MoshirMoshir/DIY-TaTaCon/src/assets/images/Wiring.jpg

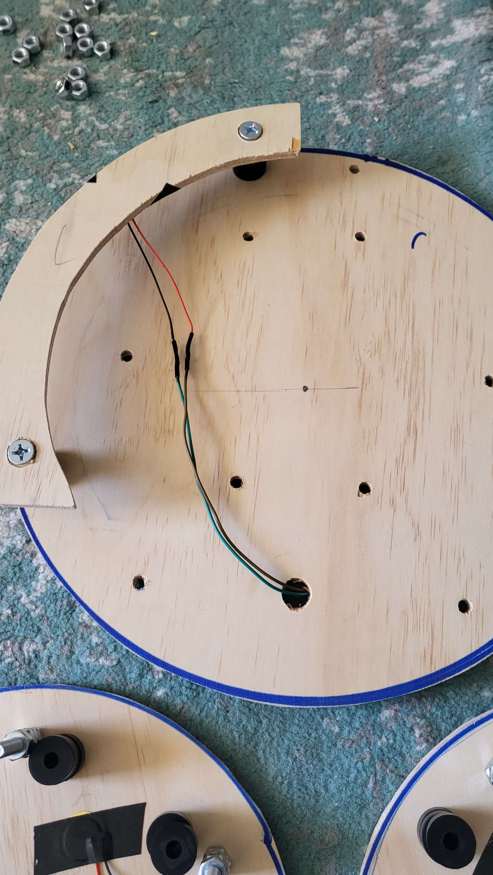
src/assets/images/Wiring.jpg
