MoshirMoshir/DIY-TaTaCon/src/assets/images/Big_Assemble.jpg

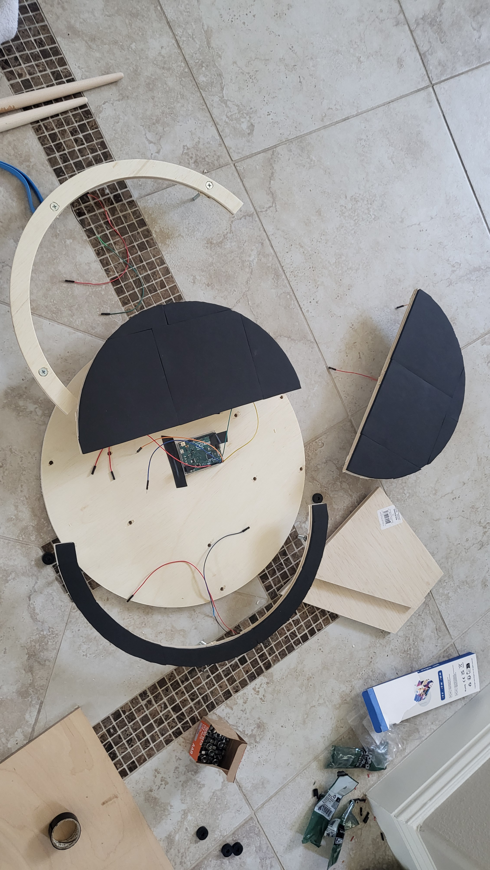
src/assets/images/Big_Assemble.jpg
