MoshirMoshir/DIY-TaTaCon/public/og-image.jpg

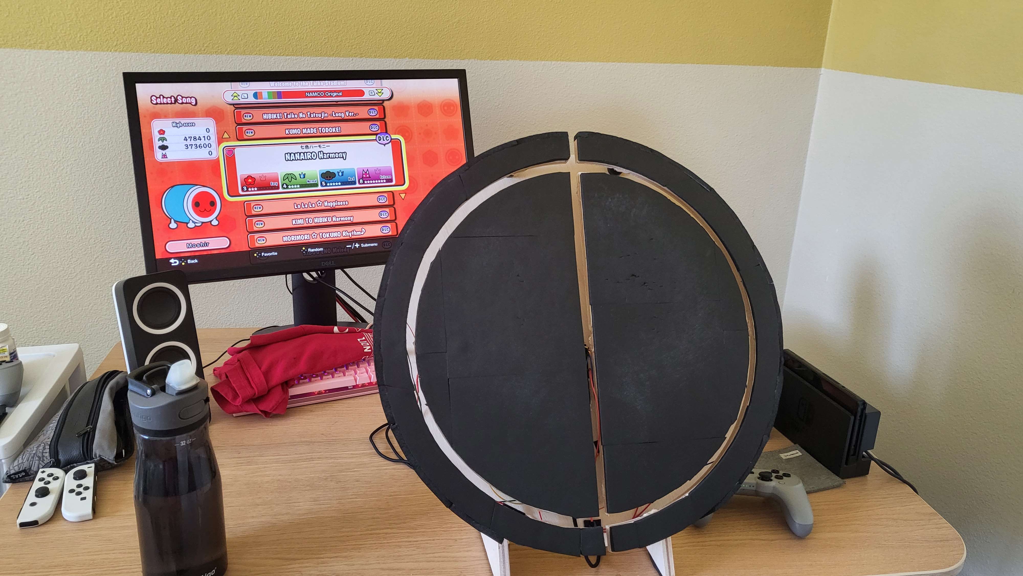
public/og-image.jpg
