MoshirMoshir/DIY-TaTaCon/src/assets/images/Arduino_Back.jpg

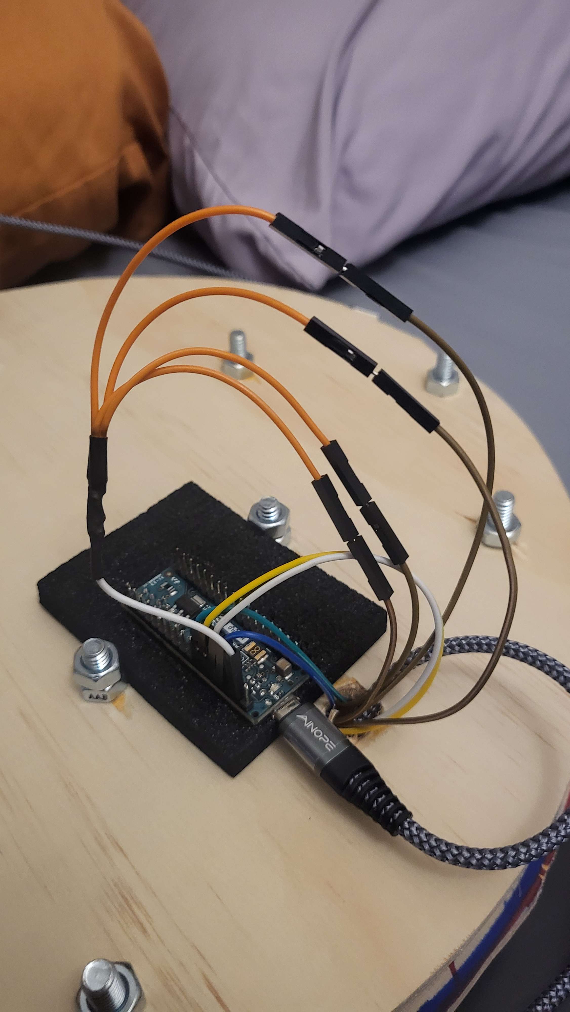
src/assets/images/Arduino_Back.jpg
