MoshirMoshir/DIY-TaTaCon/src/assets/images/Assembeld.jpg

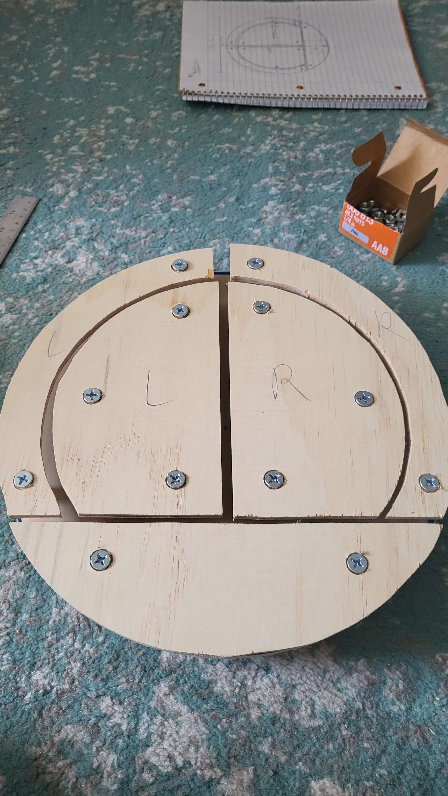
src/assets/images/Assembeld.jpg
