MoshirMoshir/DIY-TaTaCon/src/assets/images/Big_No_Rubber.jpg

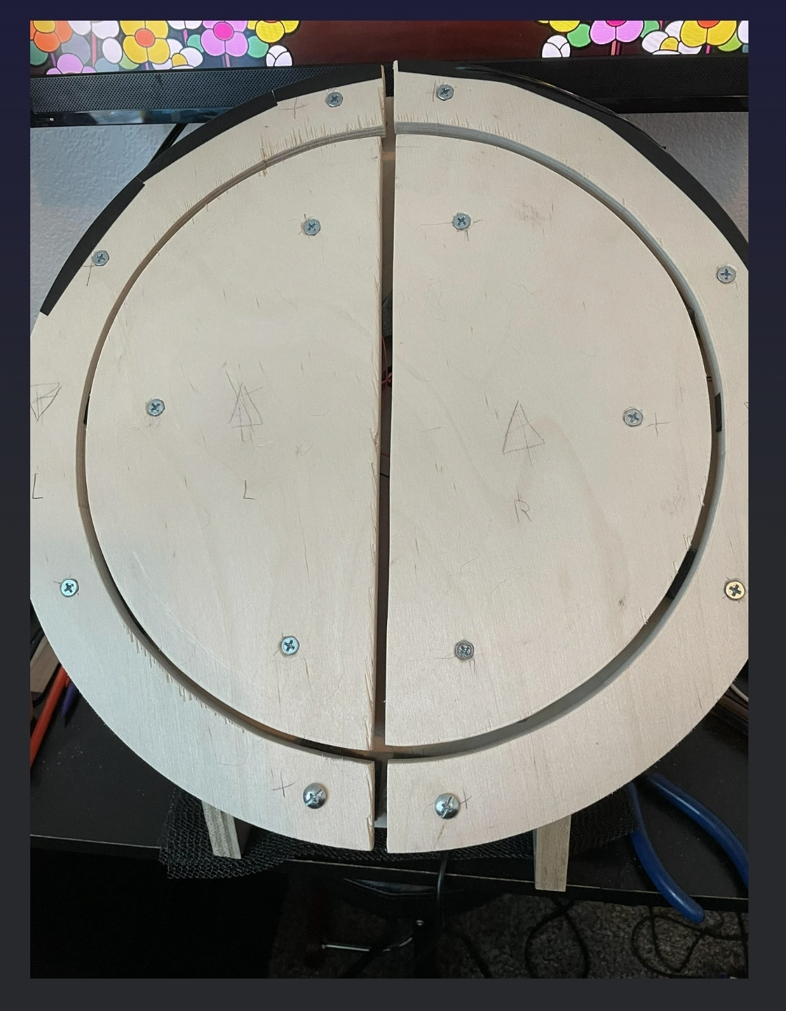
src/assets/images/Big_No_Rubber.jpg
