MoshirMoshir/DIY-TaTaCon/src/assets/images/Big_Wood_Cut.jpg

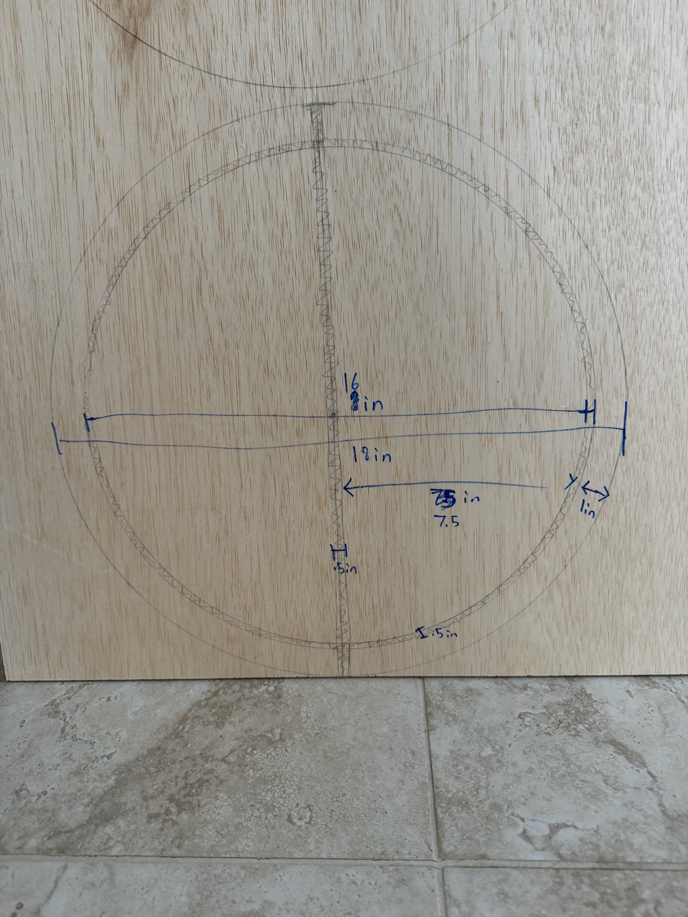
src/assets/images/Big_Wood_Cut.jpg
