MoshirMoshir/DIY-TaTaCon/src/assets/images/Cutting_Rubber.jpg

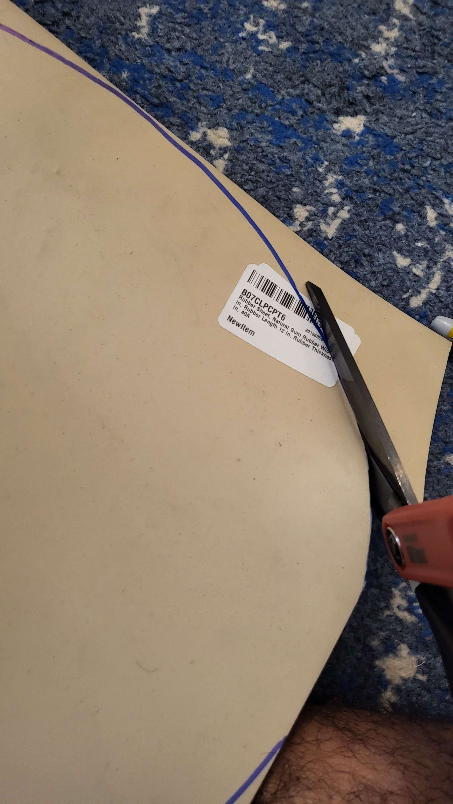
src/assets/images/Cutting_Rubber.jpg
