MoshirMoshir/DIY-TaTaCon/src/assets/images/Extended.jpg

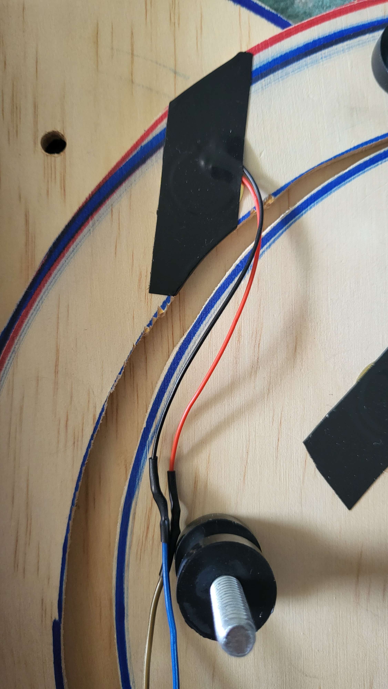
src/assets/images/Extended.jpg
