MoshirMoshir/DIY-TaTaCon/src/assets/images/Glueing.jpg

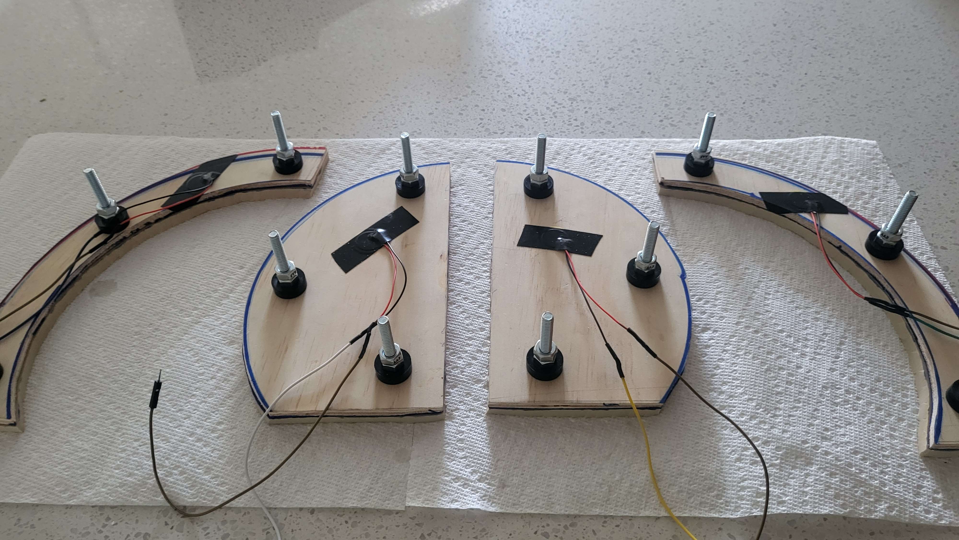
src/assets/images/Glueing.jpg
