MoshirMoshir/DIY-TaTaCon/src/assets/images/Nuts.jpg

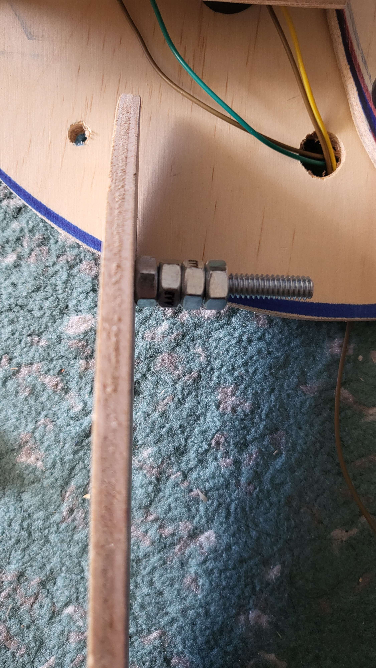
src/assets/images/Nuts.jpg
