MoshirMoshir/DIY-TaTaCon/src/assets/images/Piezo_Sensors.jpg

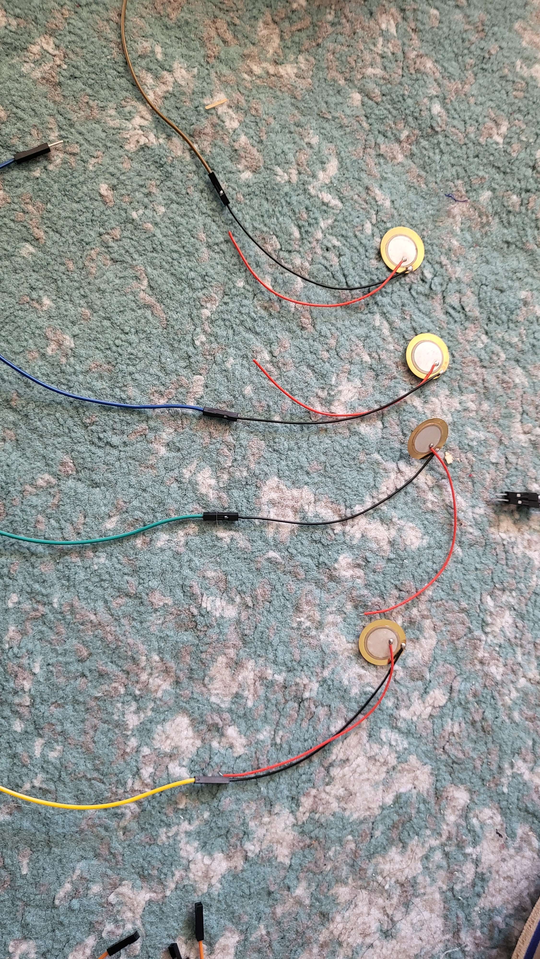
src/assets/images/Piezo_Sensors.jpg
