MoshirMoshir/DIY-TaTaCon/src/assets/images/Small_TaTaCon.jpg

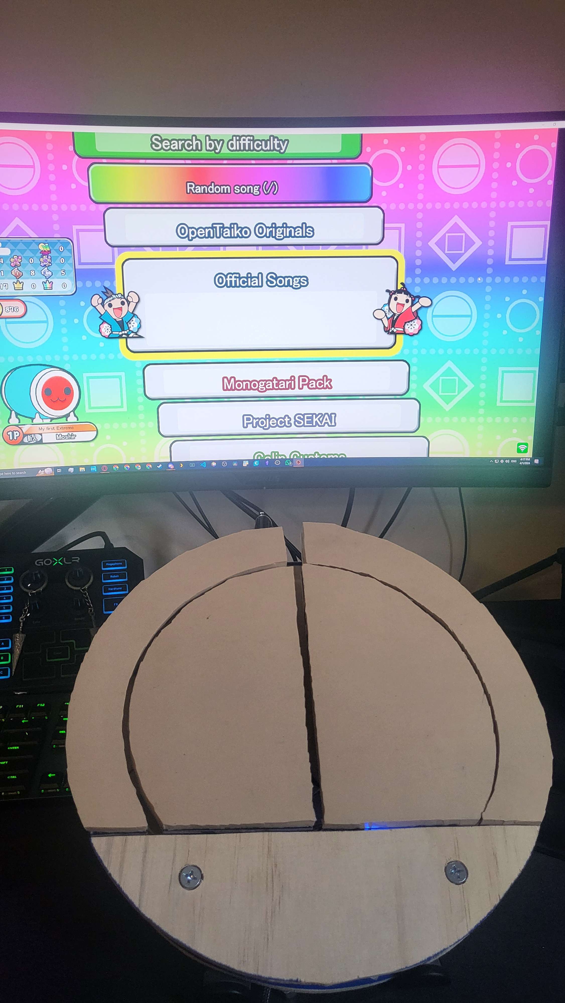
src/assets/images/Small_TaTaCon.jpg
