MoshirMoshir/DIY-TaTaCon/src/assets/images/Small_Uncut.jpg

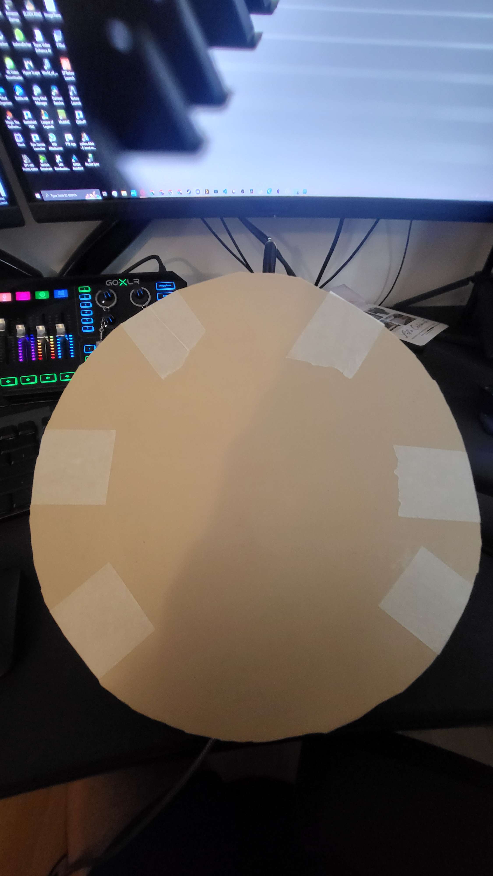
src/assets/images/Small_Uncut.jpg
