MoshirMoshir/DIY-TaTaCon/src/assets/images/Split.jpg

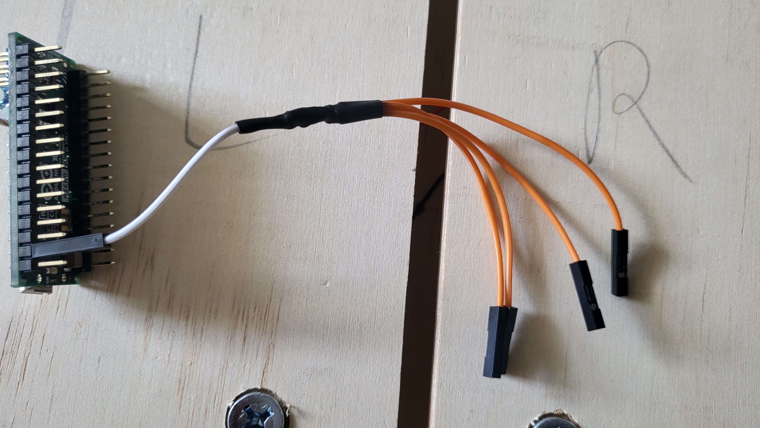
src/assets/images/Split.jpg
