MoshirMoshir/DIY-TaTaCon/src/assets/images/stand.jpg

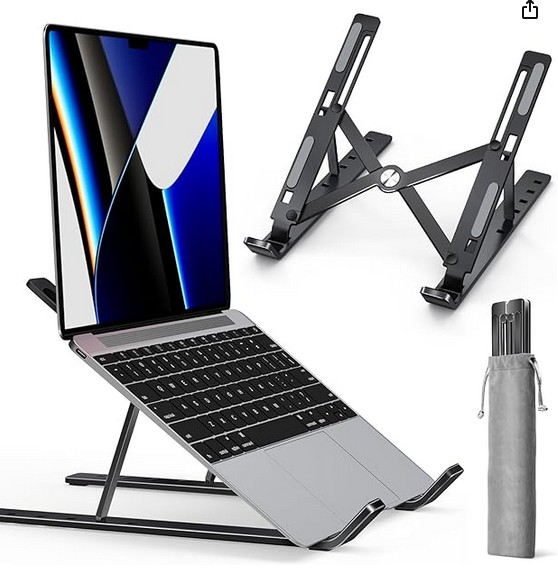
src/assets/images/stand.jpg
