MoshirMoshir/DIY-TaTaCon/src/assets/images/Stripping.jpg

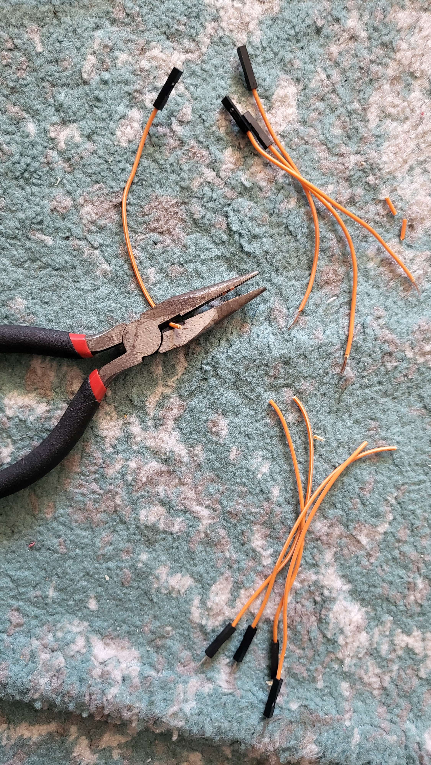
src/assets/images/Stripping.jpg
