MoshirMoshir/DIY-TaTaCon/src/assets/images/Washers.jpg

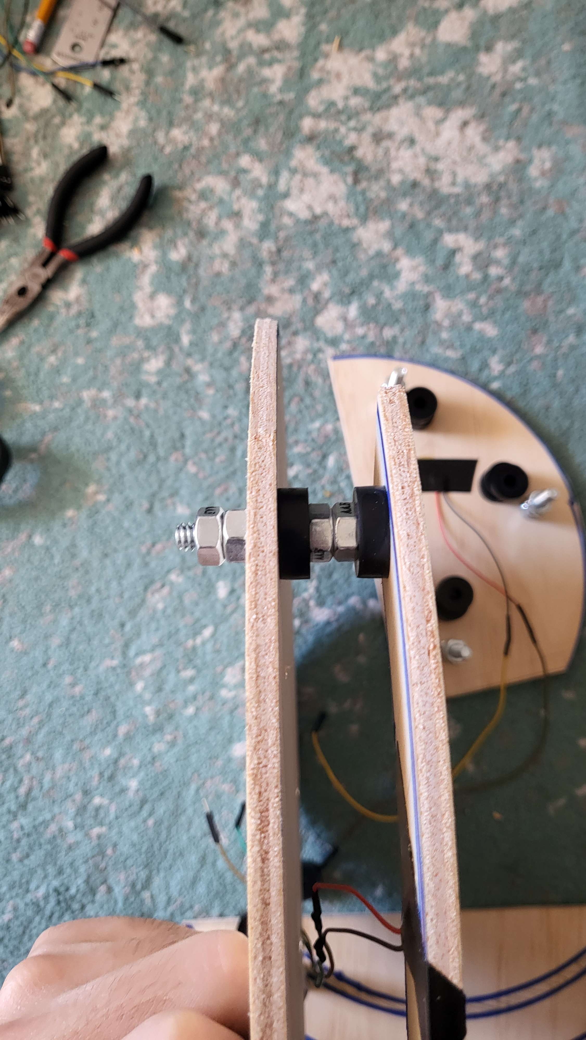
src/assets/images/Washers.jpg
