MoshirMoshir/DIY-TaTaCon/src/assets/images/Wires.jpg

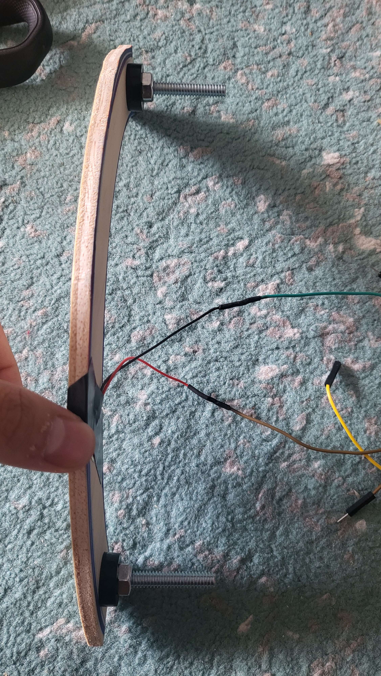
src/assets/images/Wires.jpg
