MoshirMoshir/DIY-TaTaCon/src/assets/images/Wood.jpg

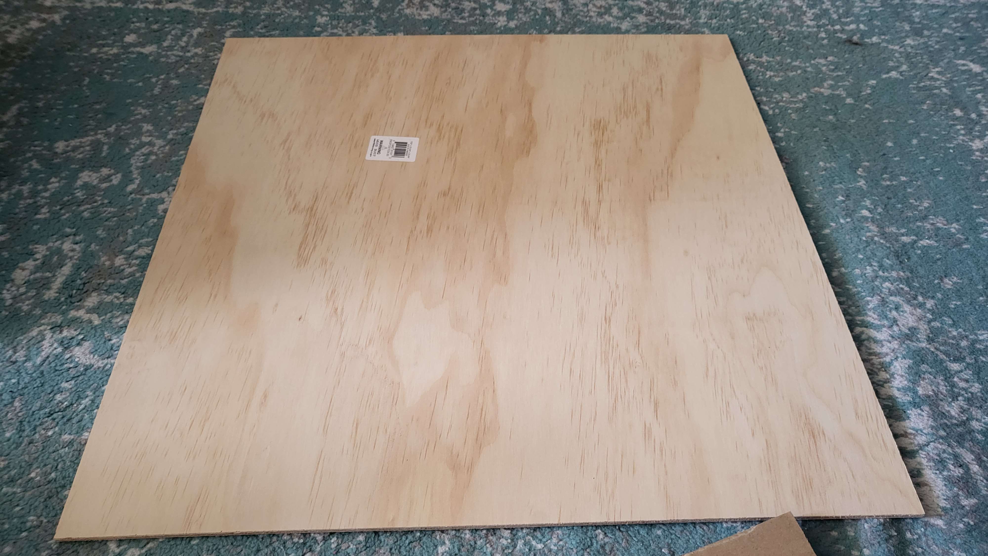
src/assets/images/Wood.jpg
