MoshirMoshir/DIY-TaTaCon/src/assets/images/Wood_Cut.jpg

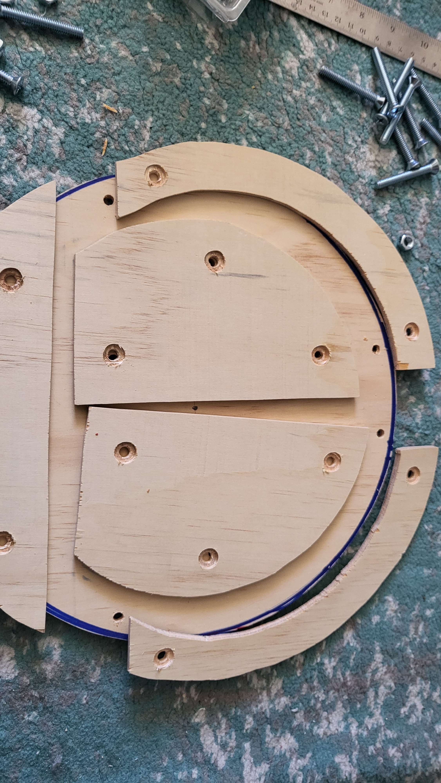
src/assets/images/Wood_Cut.jpg
