MoshirMoshir/DIY-TaTaCon/src/assets/images/Materials_1.jpg

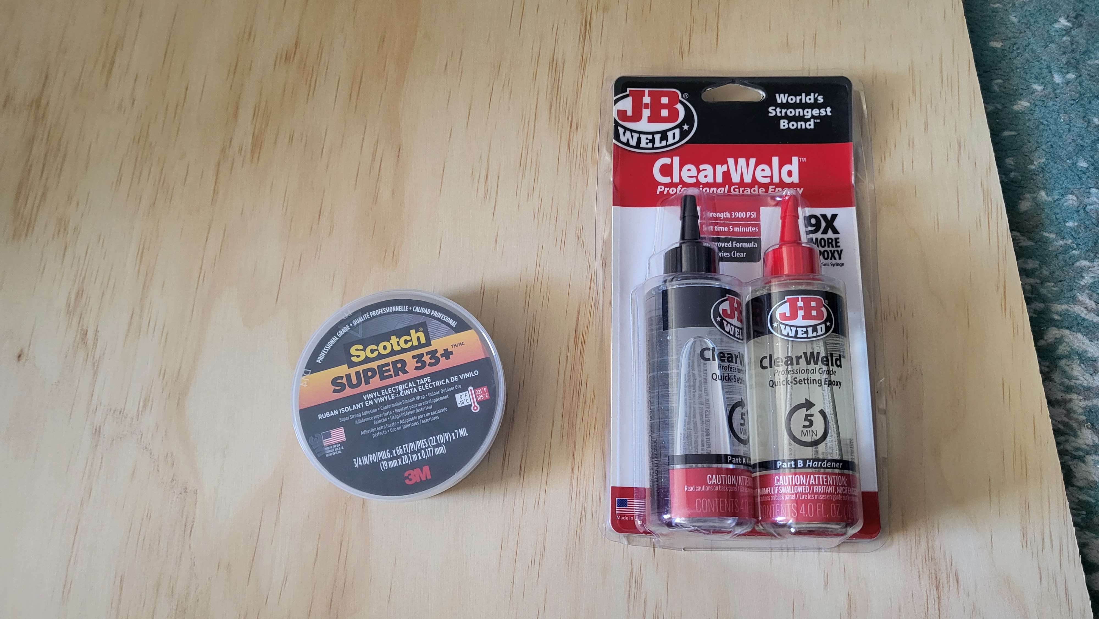
src/assets/images/Materials_1.jpg
