MoshirMoshir/DIY-TaTaCon/src/assets/images/Materials_2.jpg

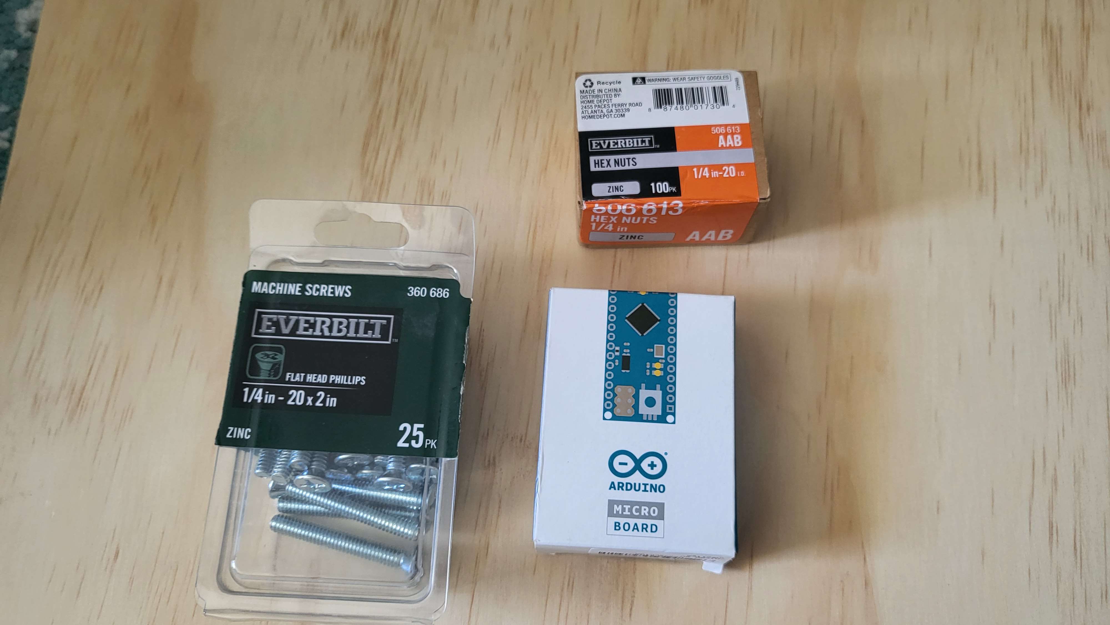
src/assets/images/Materials_2.jpg
