MoshirMoshir/DIY-TaTaCon/src/content/guide/00-getting-started.mdx

---
title: "Getting Started"
stepNumber: 0
shortTitle: "Start"
description: "What you'll need and what to expect before building your TaTaCon."
heroImage: "Materials_1.jpg"
order: 0
---
import { Image } from "astro:assets";
import Callout from "../../components/Callout.astro";
import materialsImg from "../../assets/images/Materials_1.jpg";
import materials2Img from "../../assets/images/Materials_2.jpg";

Alright, you've decided to create your own TaTaCon instead of buying a Hori or one of those knockoffs. Here's what you need to know before you begin.

## Before You Start

<Callout type="note">
  If you are not familiar or a beginner with tech/engineering, this shouldn't be too difficult, but will still require a bit of effort. If you are comfortable with electronics/engineering, this should be a breeze — feel free to make modifications as needed!
</Callout>

- This will probably cost you a little more than a Hori
- Soldering skills are optional, but would help tremendously
- You will need access to a computer with Windows, Linux, or macOS

## Required Tools

If you are unable to get easy access to these tools (or it's too expensive to rent), you're better off buying a TaTaCon.

- **Electric Jigsaw** — you could use a handsaw but a powered jigsaw is preferred
- **Drill with drill bits**
- **Scissors**
- **Ruler**
- **Soldering kit** *(optional)*
- **Wire cutters** *(optional)*

<Callout type="warning">
  If you do not feel comfortable handling any of the above tools, you're better off buying a TaTaCon.
</Callout>

## Materials Preview

<div class="my-6 grid gap-4 sm:grid-cols-2">
  <Image src={materialsImg} alt="Required materials overview" widths={[400, 700]} class="rounded-lg" loading="lazy" />
  <Image src={materials2Img} alt="Additional materials" widths={[400, 700]} class="rounded-lg" loading="lazy" />
</div>

Check the [Costs page](/costs/) for a detailed breakdown of everything you'll need and how much it costs.

If you're still good to go, head to **Step 1** to choose your size!
