MoshirMoshir/DIY-TaTaCon/src/assets/images/Assembly.jpg

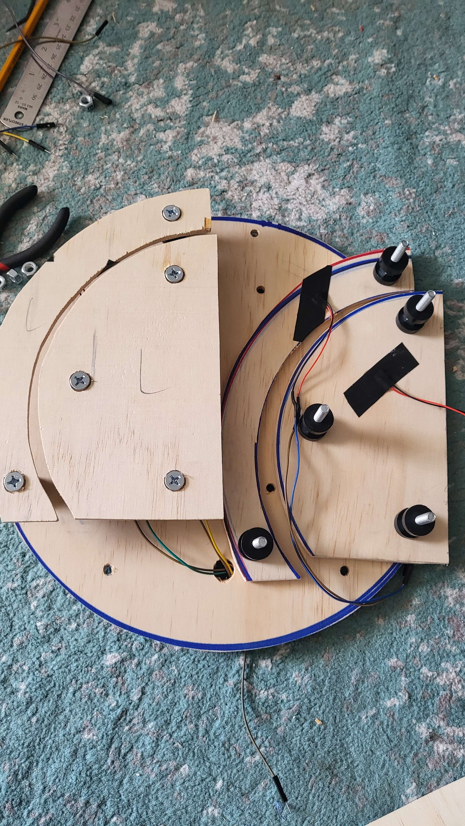
src/assets/images/Assembly.jpg
