MoshirMoshir/DIY-TaTaCon/src/assets/images/Software_Setup.png

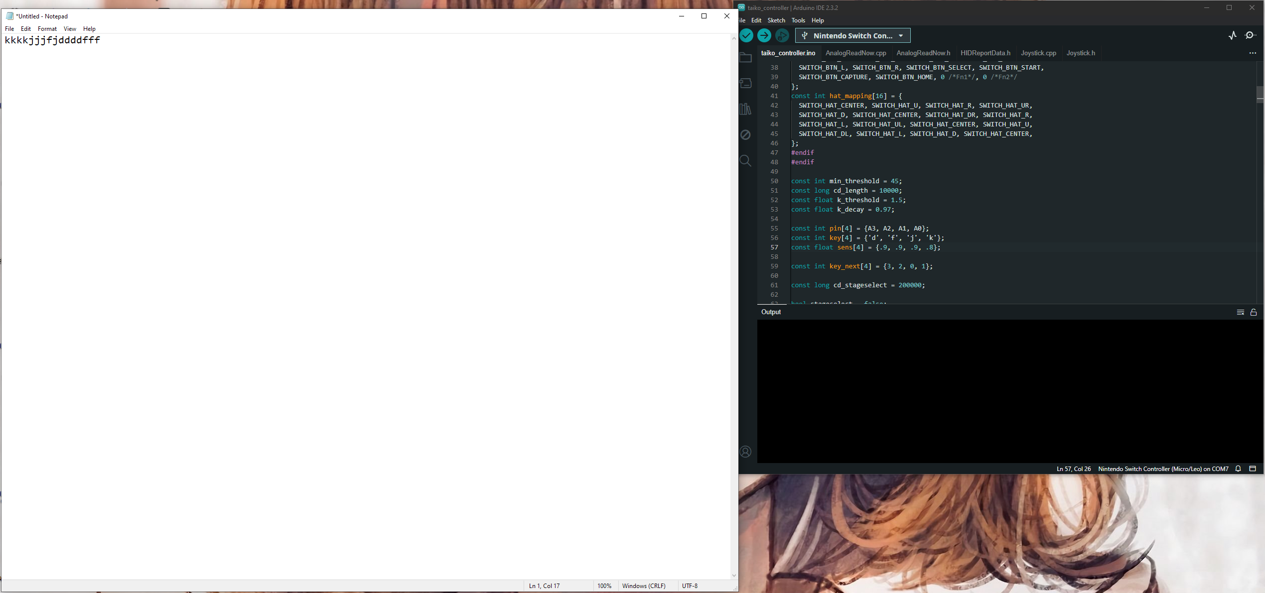
src/assets/images/Software_Setup.png
