MoshirMoshir/DIY-TaTaCon/src/assets/images/Wood_Measure.jpg

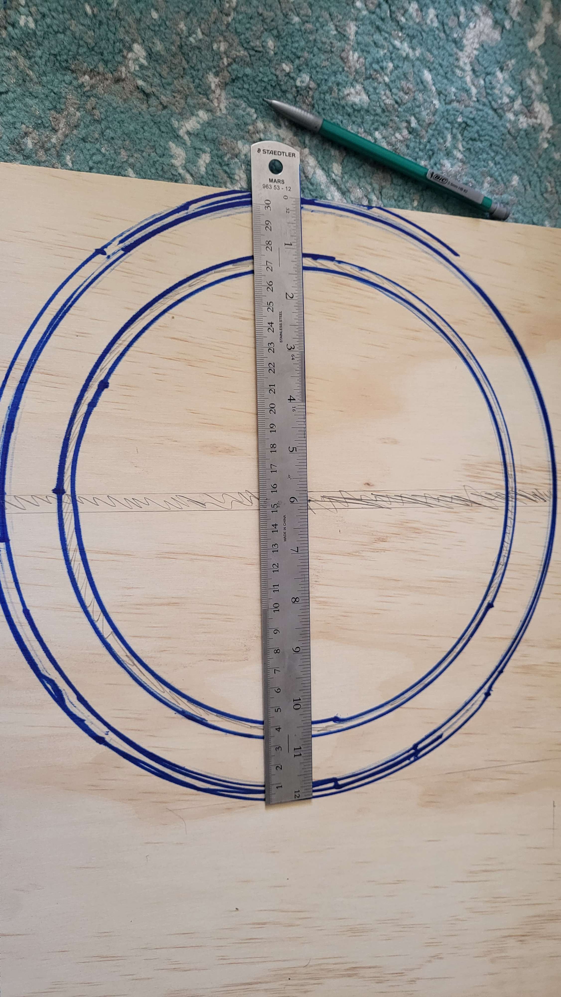
src/assets/images/Wood_Measure.jpg
